object1037/pacer/README.md

# Pacer

A Pomodoro timer to help you focus.
