object1037/pacer/hardware/README.md

# Pacer hardware

* [jlcpcb/production_files](jlcpcb/production_files): Production files (Gerber + Assembly)
* [case](case): Case 3D data
* [BOM_ext.md](BOM_ext.md): Extra parts for hand-soldering and assembly
