object1037/pacer/hardware/BOM_ext.md

# BOM for handsolder/assembly

## Akizuki

Use https://akizukidenshi.com/catalog/quickorder/blanketorder.aspx

```
104291 2
112343 1
104118 1
100308 1
115368 1
115740 1
```

## Other

- Pinheader (or conthrough) 2x2P
- AA battery
- 3DP case
- M2 x 3mm x 3mm insert nut x2
- M2 x 10mm screw x2
