object1037/pacer/hardware/case/switch_cover.step

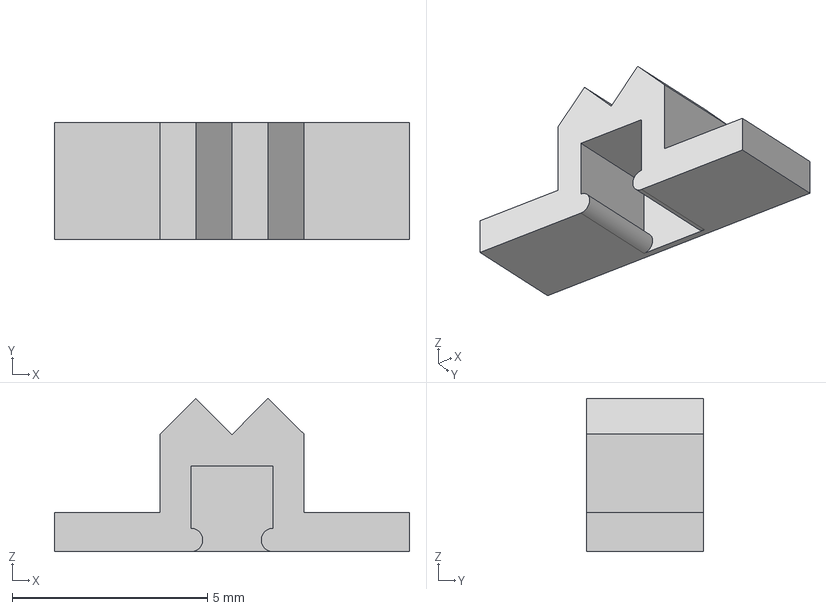
[picture p1: CAD file, 2026-09-16]
hardware/case/switch_cover.step
9.10 x 3.00 x 3.93 mm
