object1037/pacer/hardware/pacer.step

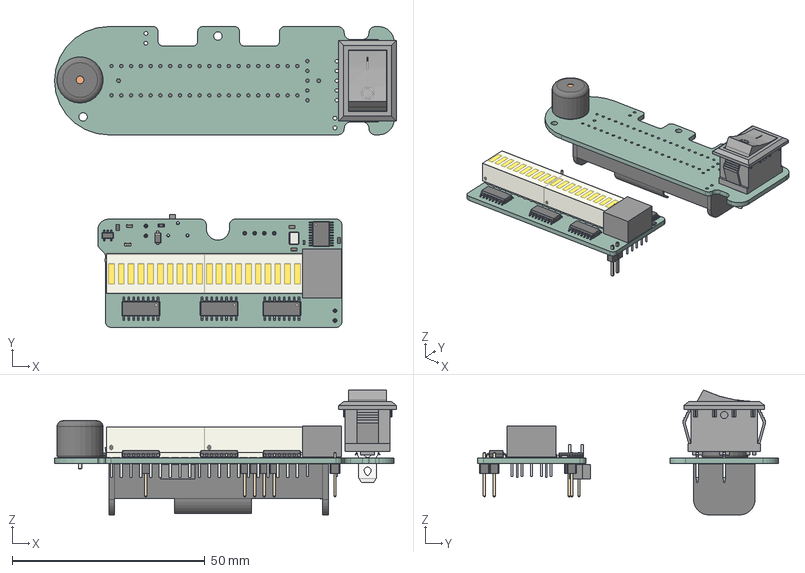
[picture p2: CAD file, 2026-07-24]
hardware/pacer.step
88.8 x 78.1 x 32.4 mm
Leads x 2
Buzzer_12x9.5RM7.6
HDSP-4840 x 2
R_Array_Convex_4x0603
R_0603_1608Metric x 3
SOIC-16_3.9x9.9mm_P1.27mm x 3
C_0603_1608Metric x 4
TSSOP-20_4.4x6.5mm_P0.65mm
TSOP-5_1.65x3.05mm_P0.95mm
D_SOD-123F
Crystal_SMD_3225-4Pin_3.2x2.5mm
C_0402_1005Metric
Blade_001
Blade_002
Base_w_text
knob001
PinHeader_1x02_P2.54mm_Vertical x 2
KEYSTONE 2460
PinHeader_1x04_P2.54mm_Vertical
pacer_PCB_1
pacer_PCB_2
