object1037/pacer/hardware/case/case.3mf

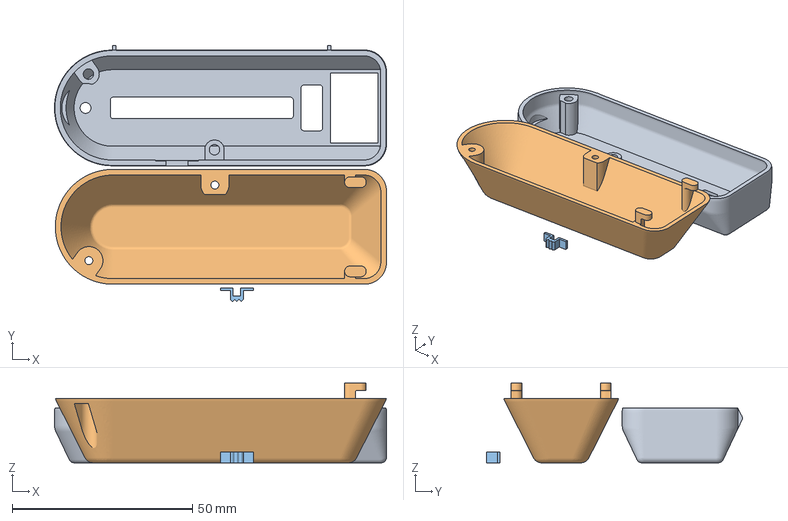
[picture p3: CAD file, 2026-07-24]
hardware/case/case.3mf
92.2 x 71.1 x 22.1 mm
case_front.step
case_back.step
switch_cover.step
