object1037/pacer/hardware/case/case_back.step

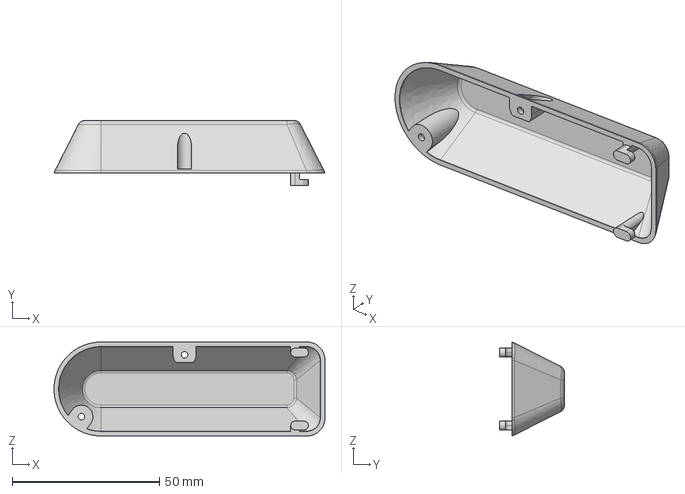
[picture p4: CAD file, 2026-07-24]
hardware/case/case_back.step
92.0 x 22.1 x 31.9 mm
