object1037/pacer/hardware/case/case_front.step

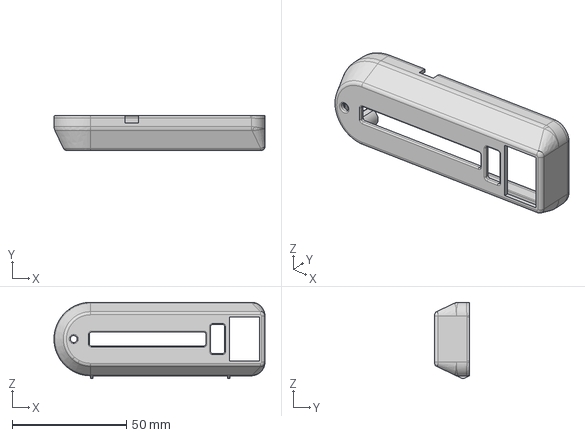
[picture p5: CAD file, 2026-07-24]
hardware/case/case_front.step
92.2 x 15.2 x 33.4 mm
