object1037/pacer/hardware/pacer.kicad_pcb

## KiCad design hardware/pacer.kicad_pcb (2026-10-09)

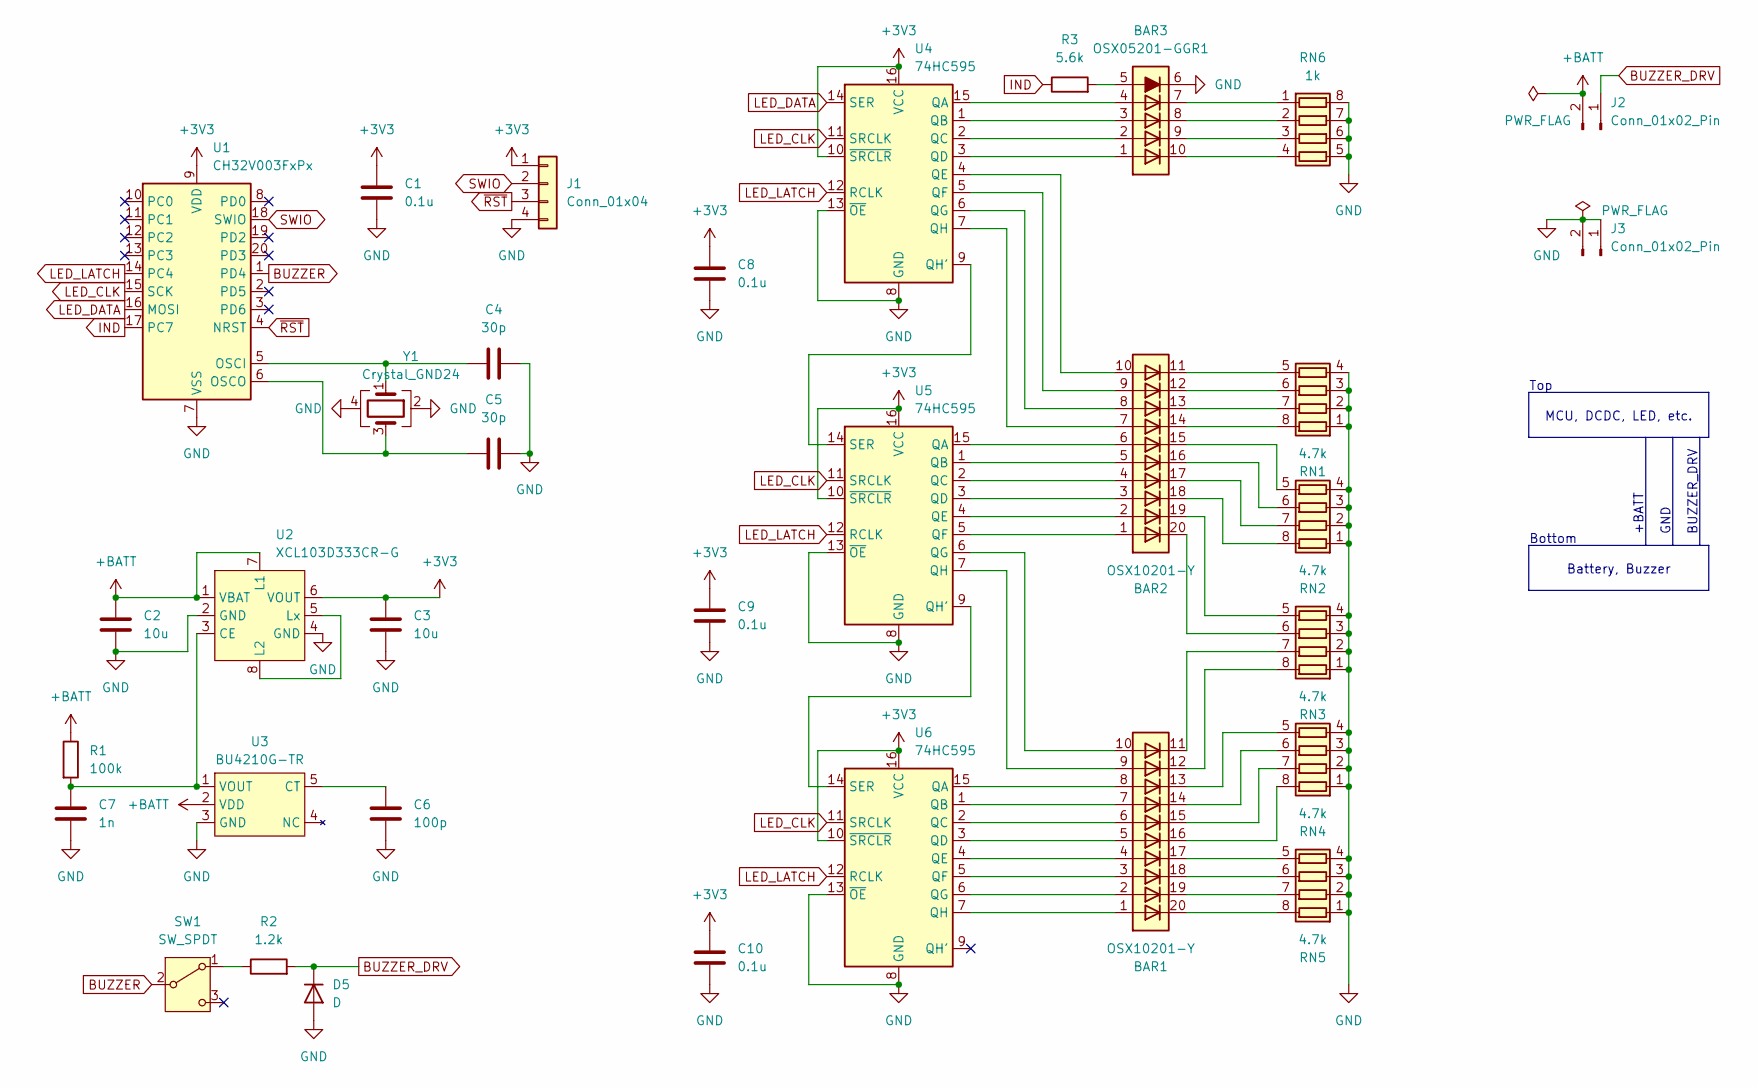
[picture p6: schematic pacer.kicad_sch]

Parts:
BAR1, BAR2: OSX10201-Y; HDSP-4840
BAR3: OSX05201-GGR1
C1, C8, C9, C10: 0.1u; C_0402_1005Metric_Pad0.74x0.62mm_HandSolder
C2, C3: 10u; C_0603_1608Metric_Pad1.08x0.95mm_HandSolder
C4, C5: 30p; C_0603_1608Metric_Pad1.08x0.95mm_HandSolder
C6: 100p; C_0402_1005Metric_Pad0.74x0.62mm_HandSolder
C7: 1n; C_0402_1005Metric_Pad0.74x0.62mm_HandSolder
D5: D; SOD-123FL
J1: Conn_01x04; PinHeader_1x04_P2.54mm_Vertical
J2, J3: Conn_01x02_Pin; PinHeader_1x02_P2.54mm_Vertical
R1: 100k; R_0603_1608Metric_Pad0.98x0.95mm_HandSolder
R2: 1.2k; R_0603_1608Metric_Pad0.98x0.95mm_HandSolder
R3: 5.6k; R_0603_1608Metric_Pad0.98x0.95mm_HandSolder
RN1, RN2, RN3, RN4, RN5: 4.7k; R_Array_Convex_4x0603
RN6: 1k; R_Array_Convex_4x0603
SW1: SW_SPDT; SW_SPDT_IS-1245T
U1: CH32V003FxPx; TSSOP-20_4.4x6.5mm_P0.65mm
U2: XCL103D333CR-G; CL2025-02
U3: BU4210G-TR; SSOP5
U4, U5, U6: 74HC595; SOIC-16_3.9x9.9mm_P1.27mm
Y1: Crystal_GND24; Crystal_SMD_3225-4Pin_3.2x2.5mm

Connections:
+3V3: C1.1, C3.1, C8.1, C9.1, C10.1, J1.1, U1.9 (VDD), U2.6 (VOUT), U4.10 (~SRCLR), U4.16 (VCC), U5.10 (~SRCLR), U5.16 (VCC), U6.10 (~SRCLR), U6.16 (VCC)
+BATT: C2.1, J2.2, R1.1, U2.1 (VBAT), U2.7 (L1), U3.2 (VDD)
BUZZER: SW1.2 (B), U1.1 (PD4)
BUZZER_DRV: D5.1 (K), J2.1, R2.2
GND: BAR3.6 (K), C1.2, C2.2, C3.2, C4.1, C5.2, C6.2, C7.2, C8.2, C9.2, C10.2, D5.2 (A), J1.4, J3.1, J3.2, RN1.1 (R1.1), RN1.2 (R2.1), RN1.3 (R3.1), RN1.4 (R4.1), RN2.1 (R1.1), RN2.2 (R2.1), RN2.3 (R3.1), RN2.4 (R4.1), RN3.1 (R1.1), RN3.2 (R2.1), RN3.3 (R3.1), RN3.4 (R4.1), RN4.1 (R1.1), RN4.2 (R2.1), RN4.3 (R3.1), RN4.4 (R4.1), RN5.1 (R1.1), RN5.2 (R2.1), RN5.3 (R3.1), RN5.4 (R4.1), RN6.5 (R4.2), RN6.6 (R3.2), RN6.7 (R2.2), RN6.8 (R1.2), U1.7 (VSS), U2.2 (GND), U2.4 (GND), U3.3 (GND), U4.8 (GND), U4.13 (~OE), U5.8 (GND), U5.13 (~OE), U6.8 (GND), U6.13 (~OE), Y1.2, Y1.4
IND: R3.1, U1.17 (PC7)
LED_CLK: U1.15 (SCK), U4.11 (SRCLK), U5.11 (SRCLK), U6.11 (SRCLK)
LED_DATA: U1.16 (MOSI), U4.14 (SER)
LED_LATCH: U1.14 (PC4), U4.12 (RCLK), U5.12 (RCLK), U6.12 (RCLK)
unnamed: BAR3.5 (A), R3.2
unnamed: BAR2.14 (K), RN1.8 (R1.2)
unnamed: BAR2.13 (K), RN1.7 (R2.2)
unnamed: BAR2.12 (K), RN1.6 (R3.2)
unnamed: BAR2.11 (K), RN1.5 (R4.2)
unnamed: BAR2.18 (K), RN2.8 (R1.2)
unnamed: BAR2.17 (K), RN2.7 (R2.2)
unnamed: BAR2.16 (K), RN2.6 (R3.2)
unnamed: BAR2.15 (K), RN2.5 (R4.2)
unnamed: BAR1.12 (K), RN3.8 (R1.2)
unnamed: BAR1.11 (K), RN3.7 (R2.2)
unnamed: BAR2.20 (K), RN3.6 (R3.2)
unnamed: BAR2.19 (K), RN3.5 (R4.2)
unnamed: BAR1.16 (K), RN4.8 (R1.2)
unnamed: BAR1.15 (K), RN4.7 (R2.2)
unnamed: BAR1.14 (K), RN4.6 (R3.2)
unnamed: BAR1.13 (K), RN4.5 (R4.2)
unnamed: BAR1.20 (K), RN5.8 (R1.2)
unnamed: BAR1.19 (K), RN5.7 (R2.2)
unnamed: BAR1.18 (K), RN5.6 (R3.2)
unnamed: BAR1.17 (K), RN5.5 (R4.2)
unnamed: BAR3.7 (K), RN6.1 (R1.1)
unnamed: BAR3.8 (K), RN6.2 (R2.1)
unnamed: BAR3.9 (K), RN6.3 (R3.1)
unnamed: BAR3.10 (K), RN6.4 (R4.1)
unnamed: R2.1, SW1.1 (A)
unnamed: C4.2, U1.5 (OSCI), Y1.1
unnamed: C5.1, U1.6 (OSCO), Y1.3
unnamed: C7.1, R1.2, U2.3 (CE), U3.1 (VOUT)
unnamed: U2.5 (Lx), U2.8 (L2)
unnamed: C6.1, U3.5 (CT)
unnamed: BAR3.4 (A), U4.15 (QA)
unnamed: BAR3.3 (A), U4.1 (QB)
unnamed: BAR3.2 (A), U4.2 (QC)
unnamed: BAR3.1 (A), U4.3 (QD)
unnamed: BAR2.10 (A), U4.4 (QE)
unnamed: BAR2.9 (A), U4.5 (QF)
unnamed: BAR2.8 (A), U4.6 (QG)
unnamed: U4.9 (QH'), U5.14 (SER)
unnamed: BAR2.7 (A), U4.7 (QH)
unnamed: BAR2.6 (A), U5.15 (QA)
unnamed: BAR2.5 (A), U5.1 (QB)
unnamed: BAR2.4 (A), U5.2 (QC)
unnamed: BAR2.3 (A), U5.3 (QD)
unnamed: BAR2.2 (A), U5.4 (QE)
unnamed: BAR2.1 (A), U5.5 (QF)
unnamed: BAR1.10 (A), U5.6 (QG)
unnamed: U5.9 (QH'), U6.14 (SER)
unnamed: BAR1.9 (A), U5.7 (QH)
unnamed: BAR1.8 (A), U6.15 (QA)
unnamed: BAR1.7 (A), U6.1 (QB)
unnamed: BAR1.6 (A), U6.2 (QC)
unnamed: BAR1.5 (A), U6.3 (QD)
unnamed: BAR1.4 (A), U6.4 (QE)
unnamed: BAR1.3 (A), U6.5 (QF)
unnamed: BAR1.2 (A), U6.6 (QG)
unnamed: BAR1.1 (A), U6.7 (QH)
SWIO: J1.2, U1.18 (SWIO)
~RST: J1.3, U1.4 (NRST)

Notes on the sheet:
Battery, Buzzer
+BATT
GND
Bottom
MCU, DCDC, LED, etc.
Top
BUZZER_DRV

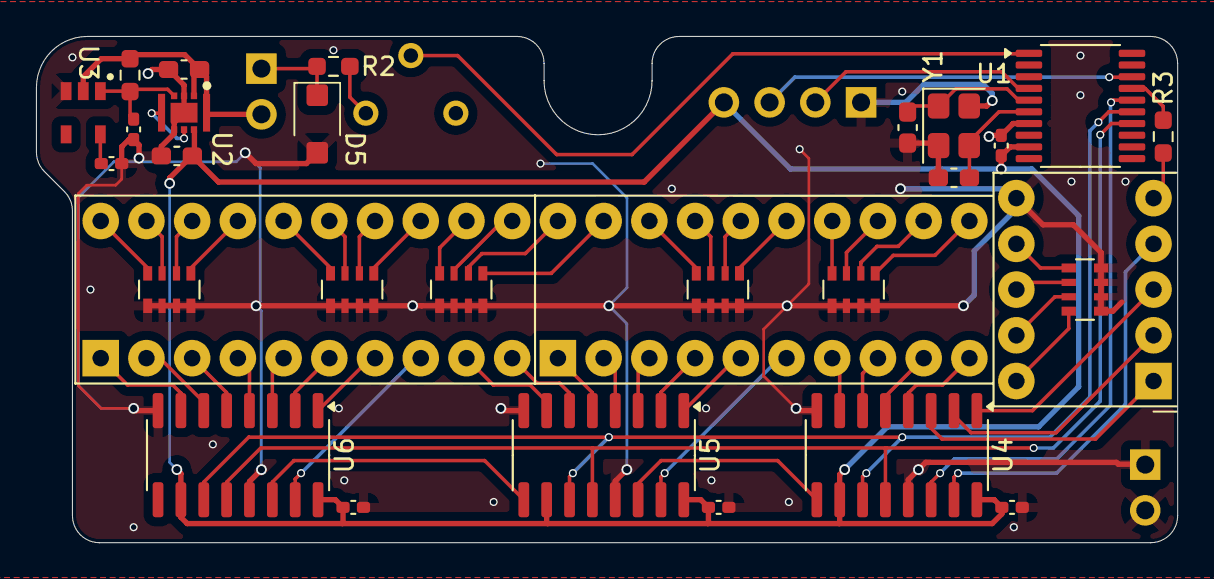
[picture p7: board pacer.kicad_pcb from above]

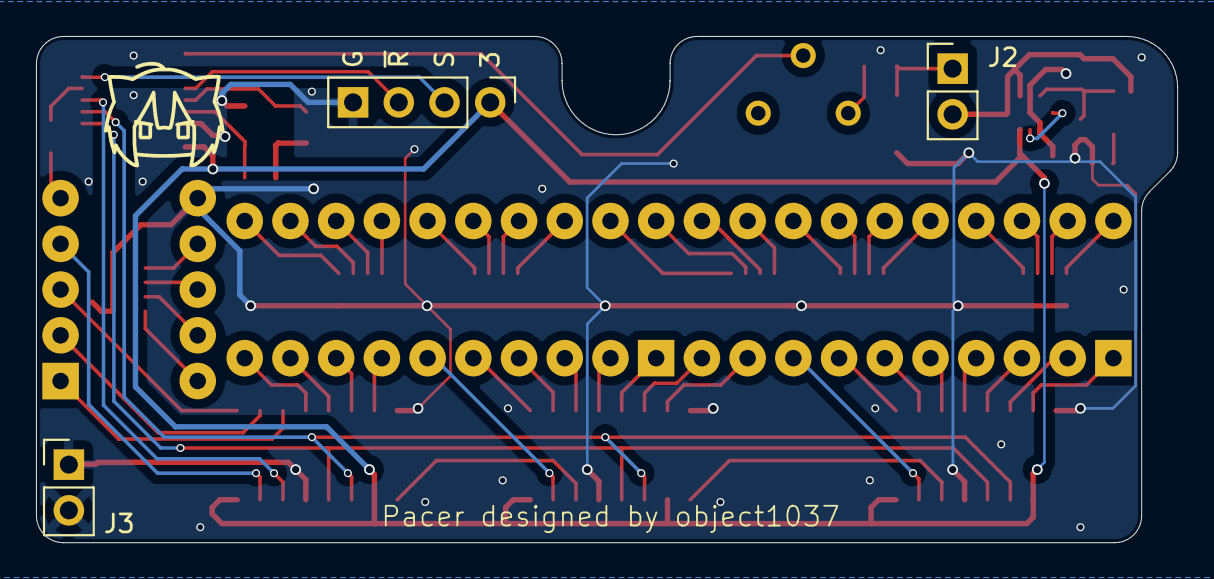
[picture p8: board pacer.kicad_pcb from below]

Board: 2 copper layers, 63.4 x 28.1 mm, 34 parts (4 on the bottom side), 68 nets.
