object1037/pacer/hardware/pacer_bottom/pacer_bottom.kicad_pcb

## KiCad design hardware/pacer_bottom/pacer_bottom.kicad_pcb (2026-10-09)

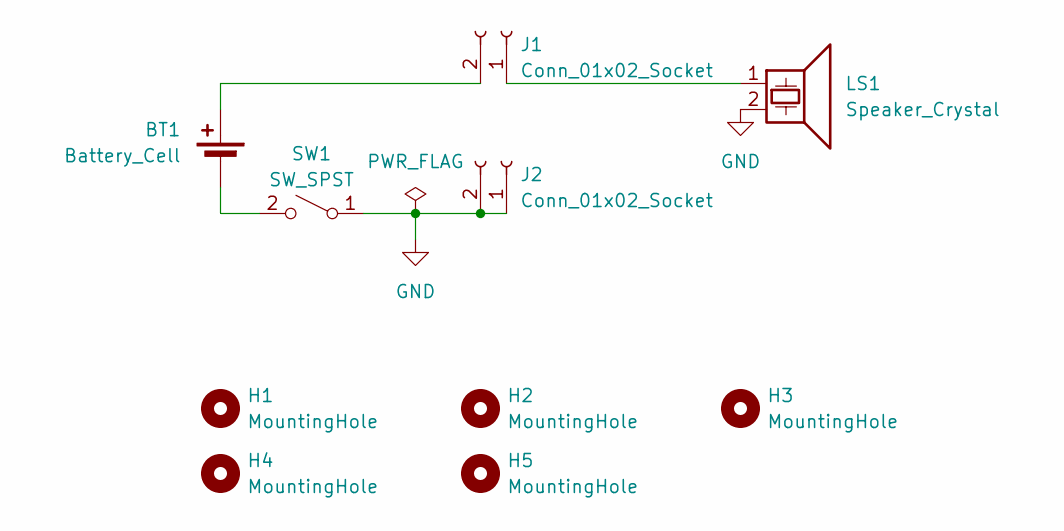
[picture p9: schematic pacer_bottom.kicad_sch]

Parts:
BT1: Battery_Cell; BatteryHolder_Keystone_2460_1xAA
H1, H2: MountingHole; OSX10201-mount
H3: MountingHole; OSX05201-mount
H4, H5: MountingHole; MountingHole_2.2mm_M2
J1, J2: Conn_01x02_Socket; PinSocket_1x02_P2.54mm_Vertical
LS1: Speaker_Crystal; buzzer_pkm13
SW1: SW_SPST; DS-850K-S

Connections:
GND: J2.1, J2.2, LS1.2, SW1.1 (A)
unnamed: BT1.1 (+), J1.2
unnamed: BT1.2 (-), SW1.2 (B)
unnamed: J1.1, LS1.1

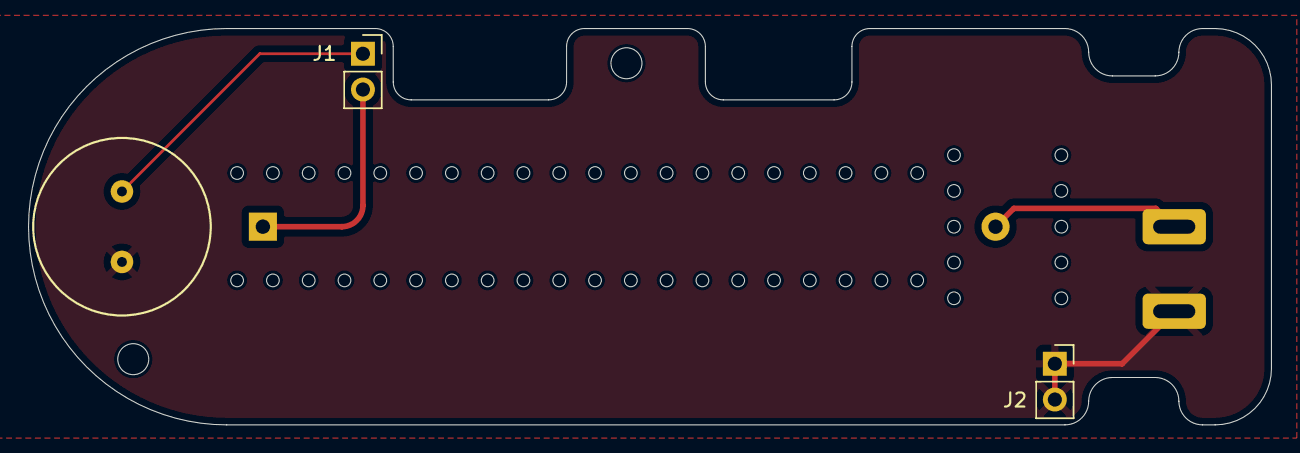
[picture p10: board pacer_bottom.kicad_pcb from above]

Board: 2 copper layers, 88.2 x 28.1 mm, 10 parts (1 on the bottom side), 4 nets.
