object1037/pacer/(commit log)

2026-07-24 PCB v1
    [case.3mf, case_back.step, case_front.step, pacer.kicad_pcb, pacer.kicad_sch, pacer.step, pacer_bottom.kicad_pcb, pacer_bottom.kicad_sch]
2026-07-25 jlcpcb production files
    [BOM-pacer.csv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]
2026-07-26 add BOM for handsolder components
2026-07-28 update switch cover design
    [switch_cover.step]
2026-07-28 add assembly parts to the BOM_ext
2026-09-16 reroute xtal
    [CPL-pacer.csv, pacer-CuBottom.gbr, pacer-CuTop.gbr, pacer-EdgeCuts.gbr, pacer-MaskBottom.gbr, pacer-MaskTop.gbr, pacer-NPTH.drl, pacer-PTH.drl]
2026-10-07 add capacitors
    [BOM-pacer.csv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]
2026-10-09 update silkscreen
    [pacer-CuBottom.gbr, pacer-CuTop.gbr, pacer-EdgeCuts.gbr, pacer-MaskBottom.gbr, pacer-MaskTop.gbr, pacer-NPTH.drl, pacer-PTH.drl, pacer-PasteBottom.gbr]
2026-10-13 update case data
2026-10-13 minor PCB fix
2026-10-13 feat: add 74HC595 display driver and LED map
2026-10-13 fix: anchor remaining-time bar at leftmost LED so it goes out right-to-left
2026-10-14 feat: blink break LED for a fixed window after each phase change
2026-10-14 fix: run phase timing in milliseconds to support 25-30 min phases
2026-10-14 minor case improvements
2026-10-15 hardware update after prototype
2026-10-20 align y-axis for printing
